liveboxandy/ZX48K-Essentials/board_photo.jpg

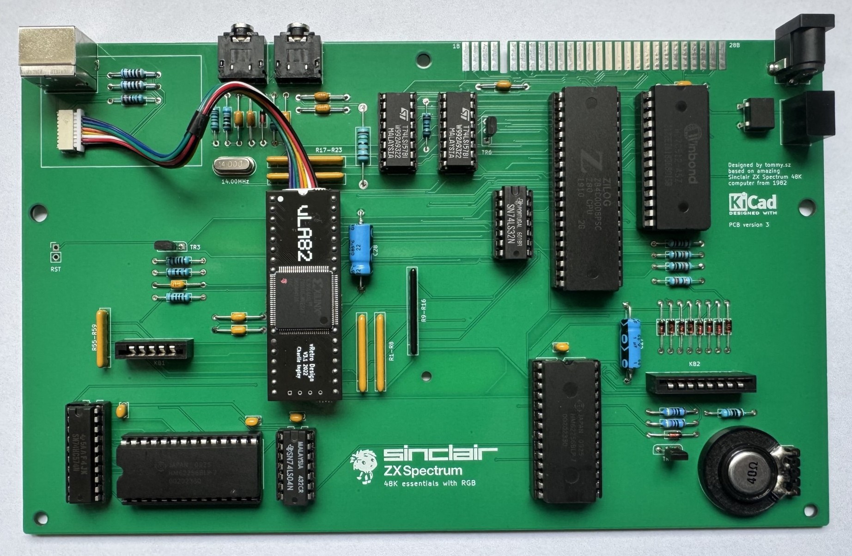
board_photo.jpg
