liveboxandy/ZX48K-Essentials/board_PICTURE.jpg

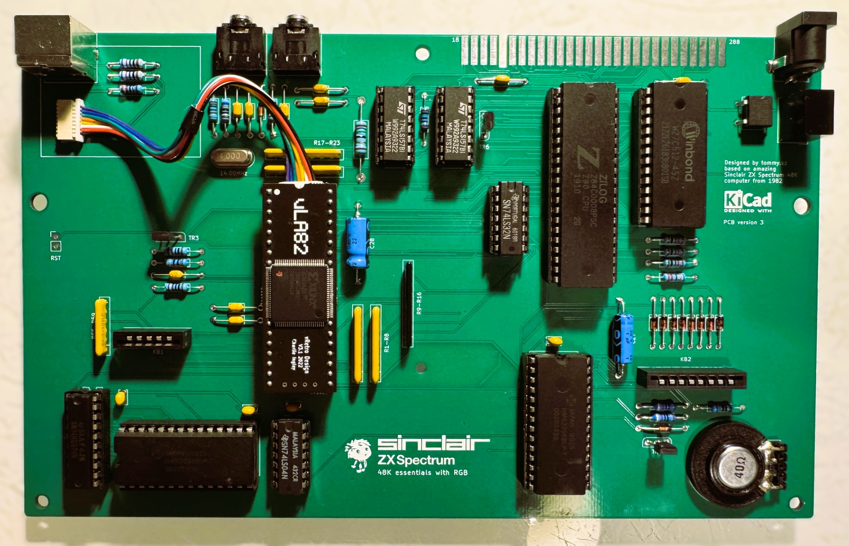
board_PICTURE.jpg
