liveboxandy/ZX48K-Essentials/ZX48K-Essentials_pcb.png

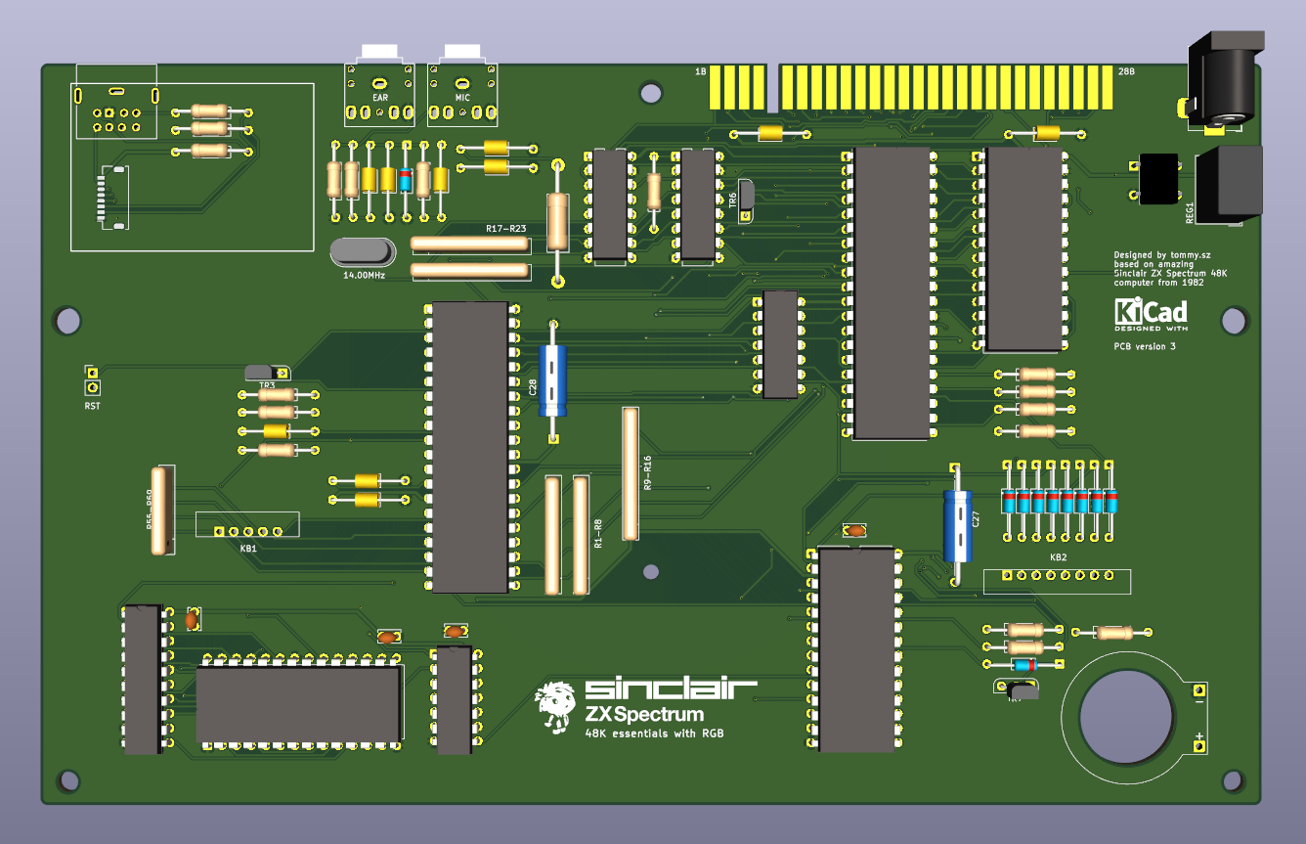
ZX48K-Essentials_pcb.png
