liveboxandy/ZX48K-Essentials/ZX 48K-Populated.png

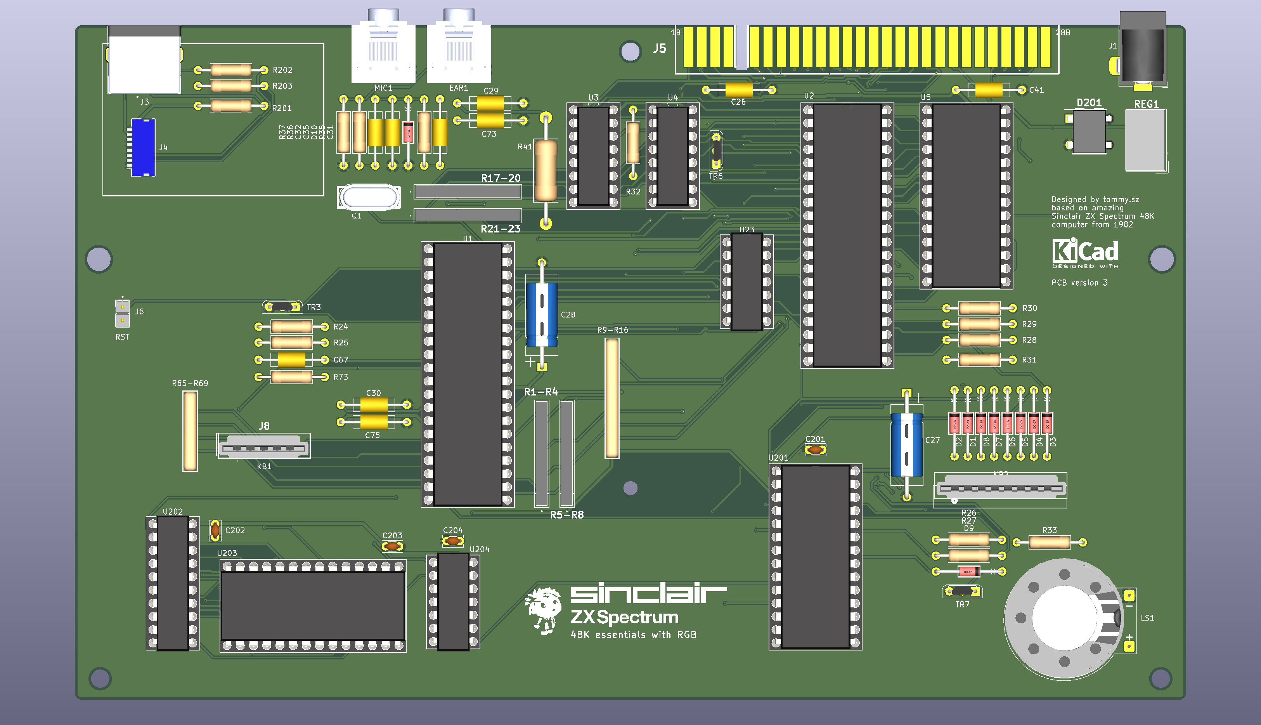
ZX 48K-Populated.png
