liveboxandy/ZX48K-Essentials/ZX 48K-UnPopulated.png

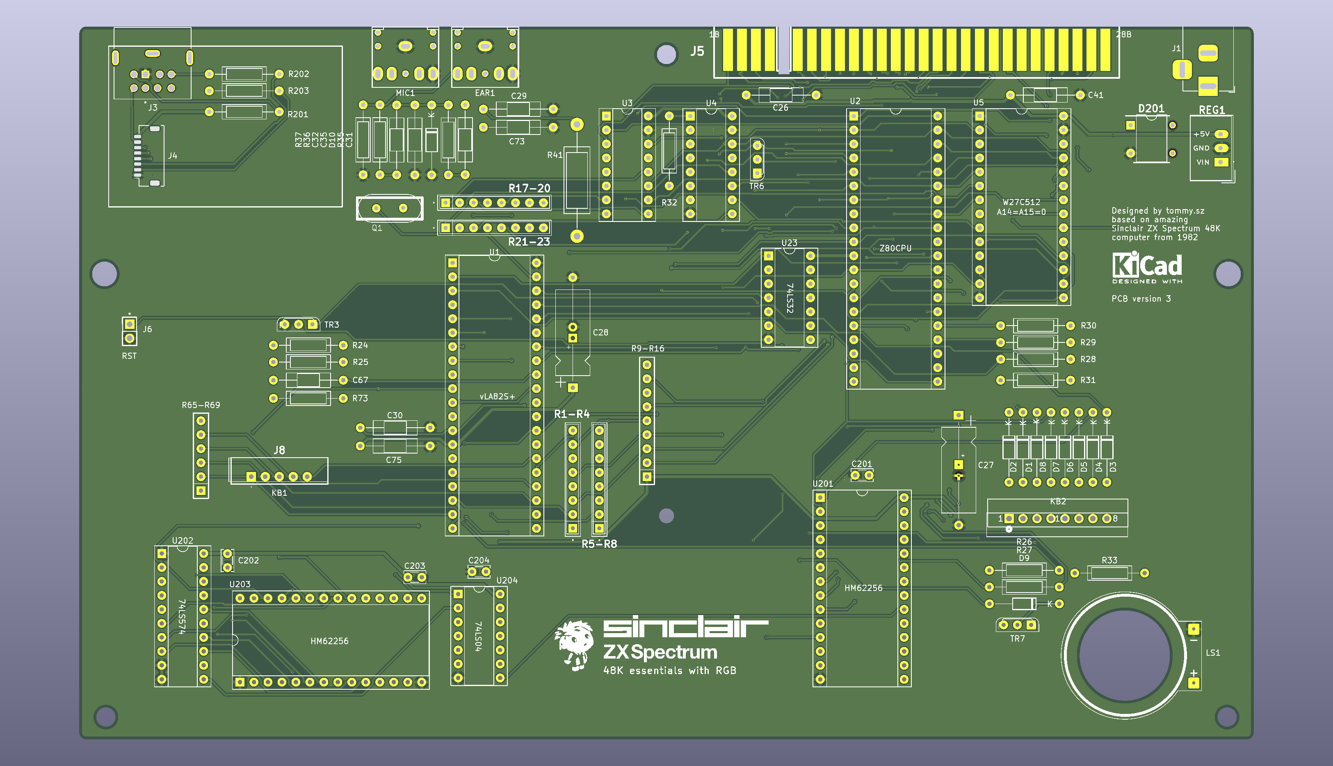
ZX 48K-UnPopulated.png
