liveboxandy/ZX48K-Essentials/ZX48essentials_BOM.pdf

## ZX48essentials - Bill of Materials

Reference | Quantity | Value | Type/Description
Resistors
R24,R37,R73 | 3 | 1K | 0.25W, R=12.7mm
R25 | 1 | 180R | 0.25W, R=12.7mm
R26,R27 | 2 | 470R | 0.25W, R=12.7mm
R28,R29,R30,R35 | 4 | 10K | 0.25W, R=12.7mm
R31 | 1 | 220K | 0.25W, R=12.7mm
R32 | 1 | 100R | 0.25W, R=12.7mm
R33,R36 | 2 | 680R | 0.25W, R=12.7mm
R41 | 1 | 15R | 0.5W or more, R=20.3mm
R201 | 1 | 220R | 0.25W, R=12.7mm
R202,R203 | 2 | 620R | 0.25W, R=12.7mm
Resistor networks
R1-R8 | 2 | 4 x 470R | 8-pin, parallel topology
R9-R16 | 1 | 8 x 8K2 | 9-pin, star topology
R17-R23 | 2 | 4 x 330R | 8-pin, parallel topology
R65-R69 | 1 | 5 x 10K | 6-pin, star topology
Capacitors
C26,C29,C30,C41 | 4 | 47nF | ceramic, axial or disc, R=12.7mm
C27 | 1 | 1uF | electrolytic, axial R=20mm or radial R=2.0mm
C28 | 1 | 22uF | electrolytic, axial R=20mm or radial R=2.0mm
C31,C32,C75 | 3 | 100nF | ceramic, axial or disc, R=12.7mm
C35 | 1 | 10nF | ceramic, axial or disc, R=12.7mm
C67 | 1 | 100pF | ceramic, axial or disc, R=12.7mm
C73 | 1 | 16pF | ceramic, axial or disc, R=12.7mm
C201,C202,C203,C204 | 4 | 100nF | ceramic, R=2.5mm, unmarked on PCB
Diodes
D1-D8,D9-10 | 10 | 1N4148
D201 | 1 | DF02M
Transistors
TR3,TR6 | 2 | ZTX313
TR7 | 1 | ZTX450
Integrated circuits
IC1 | 1 | vLA82S+ | vRetroDesign
IC2 | 1 | Z80 CPU
IC3,IC4 | 2 | 74LS157
IC5 | 1 | W27C512 | EEPROM
IC23 | 1 | 74LS32
U201,U202 | 2 | HM62256
U203 | 1 | 74LS574
U204 | 1 | 74LS04
U205 | 1 | 2450 | Traco TSR-1 or similar
Connectors
J1 | 1 | DC 5.5/2.1
J2 | 1 | 5-pin FFC/FPC | keyboard KB1
J3 | 1 | 8-pin FFC/FPC | keyboard KB2
J4,J5 | 2 | PJ-307 | MIC,EAR
J201 | 1 | Mini-DIN-8 | socket
J202 | 1 | 8-pin JST-SH1.0 | socket horizontal
Other components
Speaker | 1 | 40R | ZX Spectrum speaker
Quartz | 1 | 14.00MHz | HC-49-S
