liveboxandy/ZX48K-Essentials/ZX 48K.csv

Source: | E:\Kicad\ZX 48K\ZX 48K.kicad_sch
Date: | 2026-08-28T11:00:37
Tool: | Eeschema 10.0.4
Generator: | C:\Program Files\KiCad\7.0\bin\scripting\plugins/bom_csv_grouped_by_value_with_fp.py
Component Count: | 76
Ref | Qnty | Value | Cmp name | Footprint | Description | Vendor | DNP
C26, C29, C30, C41 | 4 | 47nF | C | MOD:C_Axial_L7.8mm_D2.4mm_P12.7mm_Horizontal | Unpolarized capacitor
C27 | 1 | 1uF | Capacitor_Electrolytic | MOD:CP_Axial_L15.6mm_D6.0mm_P20.00mm_Horizontal
C28 | 1 | 22uF | Capacitor_Electrolytic | MOD:CP_Axial_L15.6mm_D6.0mm_P20.00mm_Horizontal
C31, C32, C75 | 3 | 100nF | C | MOD:C_Axial_L7.8mm_D2.4mm_P12.7mm_Horizontal | Unpolarized capacitor
C35 | 1 | 10nF | C | MOD:C_Axial_L7.8mm_D2.4mm_P12.7mm_Horizontal | Unpolarized capacitor
C67 | 1 | 100pF | C | MOD:C_Axial_L7.8mm_D2.4mm_P12.7mm_Horizontal | Unpolarized capacitor
C73 | 1 | 16pF | C | MOD:C_Axial_L7.8mm_D2.4mm_P12.7mm_Horizontal | Unpolarized capacitor
C201, C202, C203, C204 | 4 | 100nF | C | MOD:C_Disc_D3.0mm_W1.6mm_P2.50mm | Unpolarized capacitor
D1, D2, D3, D4, D5, D6, D7, D8, D9, D10 | 10 | 1N4148 | 1N4148 | MOD:D_DO-35_SOD27_P12.70mm_Horizontal
D201 | 1 | DF02M | DF02M | MOD:DF02M | Diodes Inc DF02M, Bridge Rectifier, 1A 200V, 4-Pin DFM
EAR1 | 1 | EAR | SJ1-3525N | MOD:PJ-307
J1 | 1 | Power 9V | Barrel_Jack_3_Pin | Connector_BarrelJack:BarrelJack_Horizontal
J3 | 1 | Mini-DIN-8 | Mini-DIN-8 | MOD:KYCON_KMDGX-8S-AS | 8-pin Mini-DIN connector
J4 | 1 | vLA82S+ JST-SH1.0 Connector | JST-SH-08 | MOD:JST_SHL_SM08B-SHLS-TF_1x08-1MP_P1.00mm_Horizontal
J5 | 1 | ZX Spectrum Edge Connector | ZX_48K_EDGE_B_TOP | MOD:ZX_BUS_B_TOP | ZX Spectrum 48K Edge Connector B Top
J6 | 1 | Reset | Conn_01x02 | MOD:SAMTEC_TSW-102-07-G-S | Generic connector, single row, 01x02, script generated (kicad-library-utils/schlib/autogen/connector/)
J8 | 1 | Keyboard KB1 | 5-520315-5 | MOD:Keyboard5x1 | 5 Position FFC, FPC Connector Contacts, Vertical - 1 Sided 0.100" (2.54mm) Through Hole
J11 | 1 | Keyboard KB2 | 5-520315-8 | MOD:Keyboard8x1
LS1 | 1 | 40R | Speaker | MOD:Speaker | Speaker
MIC1 | 1 | MIC | SJ1-3525N | MOD:PJ-307
Q1 | 1 | 14Mhz | Crystal | MOD:X1 | Two pin crystal
R1-R4 | 1 | 4 x 470R | R_Pack04 | MOD:4308R102203LF | 4 resistor network, parallel topology
R5-R8 | 1 | 4 x 470R | R_Pack04 | MOD:4308R102203LF | 4 resistor network, parallel topology
R9-R16 | 1 | 8 x 8K2 | R_Network08 | Resistor_THT:R_Array_SIP9 | 8 resistor network, star topology, bussed resistors, small symbol
R17-20 | 1 | 4 x 330R | R_Pack04 | MOD:4308R102203LF | 4 resistor network, parallel topology
R21-23 | 1 | 4 x 330R | R_Pack04 | MOD:4308R102203LF | 4 resistor network, parallel topology
R24, R37, R73 | 3 | 1K | R | MOD:R_Axial_L7.8mm_D2.4mm_P12.7mm_Horizontal | Resistor
R25 | 1 | 180R | R | MOD:R_Axial_L7.8mm_D2.4mm_P12.7mm_Horizontal | Resistor
R26, R27 | 2 | 470R | R | MOD:R_Axial_L7.8mm_D2.4mm_P12.7mm_Horizontal | Resistor
R28, R29, R30, R35 | 4 | 10K | R | MOD:R_Axial_L7.8mm_D2.4mm_P12.7mm_Horizontal | Resistor
R31 | 1 | 220K | R | MOD:R_Axial_L7.8mm_D2.4mm_P12.7mm_Horizontal | Resistor
R32 | 1 | 100R | R | MOD:R_Axial_L7.8mm_D2.4mm_P12.7mm_Horizontal | Resistor
R33, R36 | 2 | 680R | R | MOD:R_Axial_L7.8mm_D2.4mm_P12.7mm_Horizontal | Resistor
R41 | 1 | 15R | R | MOD:R_Axial_DIN0414_L11.9mm_D4.5mm_P20.32mm_Horizontal | Resistor
R65-R69 | 1 | 5 x 10K | R_Network05 | MOD:R_Array_SIP6 | 5 resistor network, star topology, bussed resistors, small symbol
R201 | 1 | 220R | R | MOD:R_Axial_L7.8mm_D2.4mm_P12.7mm_Horizontal | Resistor
R202, R203 | 2 | 620R | R | MOD:R_Axial_L7.8mm_D2.4mm_P12.7mm_Horizontal | Resistor
REG1 | 1 | TSR_1-2450E | TSR_1-2450E | MOD:TSR12450E
TR3, TR6 | 2 | ZTX313 | ZTX650 | MOD:TO-92Flat
TR7 | 1 | ZTX450 | ZTX650 | MOD:TO-92Flat
U1 | 1 | ULA | ULA | MOD:DIP-40_W15.24mm_Socket
U2 | 1 | Z80 | Z80CPU | MOD:DIP-40_W15.24mm_Socket | 8-bit General Purpose Microprocessor, DIP-40
U3, U4 | 2 | 74LS157 | 74LS157 | MOD:DIP-16_W7.62mm_Socket
U5 | 1 | W27C512 | W27C512 | MOD:DIP-28_W15.24mm_Socket
U23 | 1 | 74LS32 | 74LS32 | MOD:DIP-14_W7.62mm_Socket | Quad 2-input OR
U201, U203 | 2 | 62256 | 62256 | MOD:DIP-28_W15.24mm_Socket
U202 | 1 | 74LS574 | 74LS574 | MOD:DIP-20_W7.62mm_Socket | 8-bit Register, 3-state outputs
U204 | 1 | 74LS04 | 74LS04 | MOD:DIP-14_W7.62mm_Socket | Hex Inverter
