liveboxandy/ZX48K-Essentials/STPS/4308R-102-203LF.stp

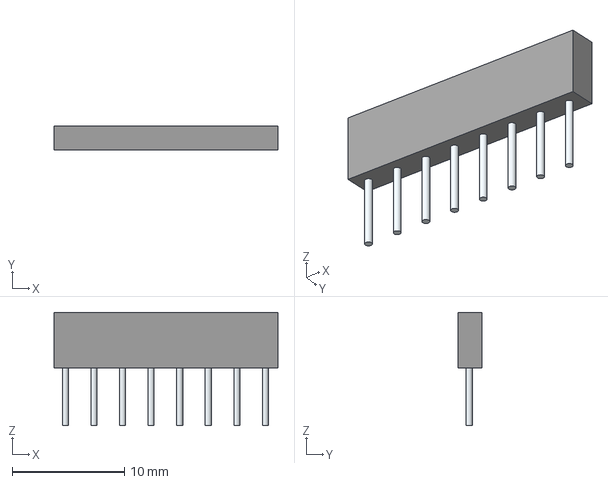
[picture p7: CAD file, 2026-08-28]
STPS/4308R-102-203LF.stp
19.9 x 2.16 x 10.1 mm
Leads x 8
