liveboxandy/ZX48K-Essentials/STPS/TSW-102-07-G-S.step

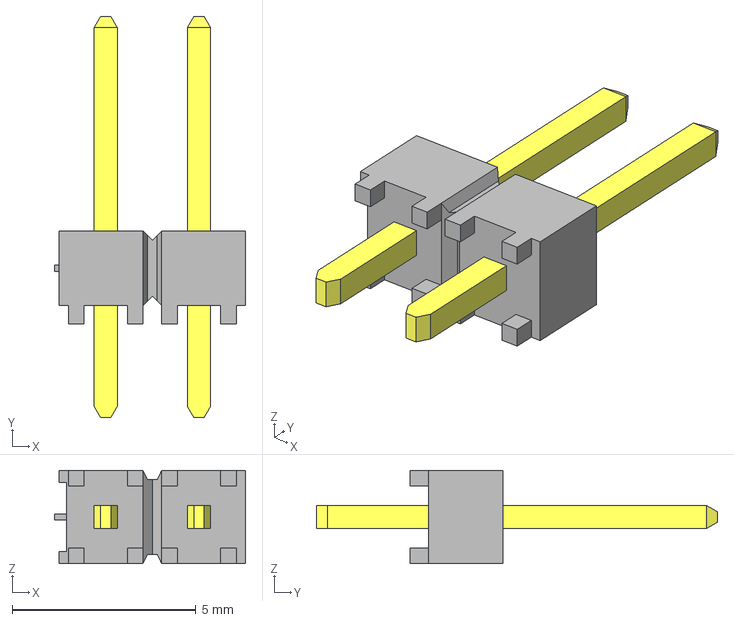
[picture p8: CAD file, 2026-08-28]
STPS/TSW-102-07-G-S.step
5.21 x 10.9 x 2.54 mm
TSW-102-07-G-S_body
T-1S6-07-TSW-1-07-2-S
