liveboxandy/ZX48K-Essentials/STPS/DF02M.stp

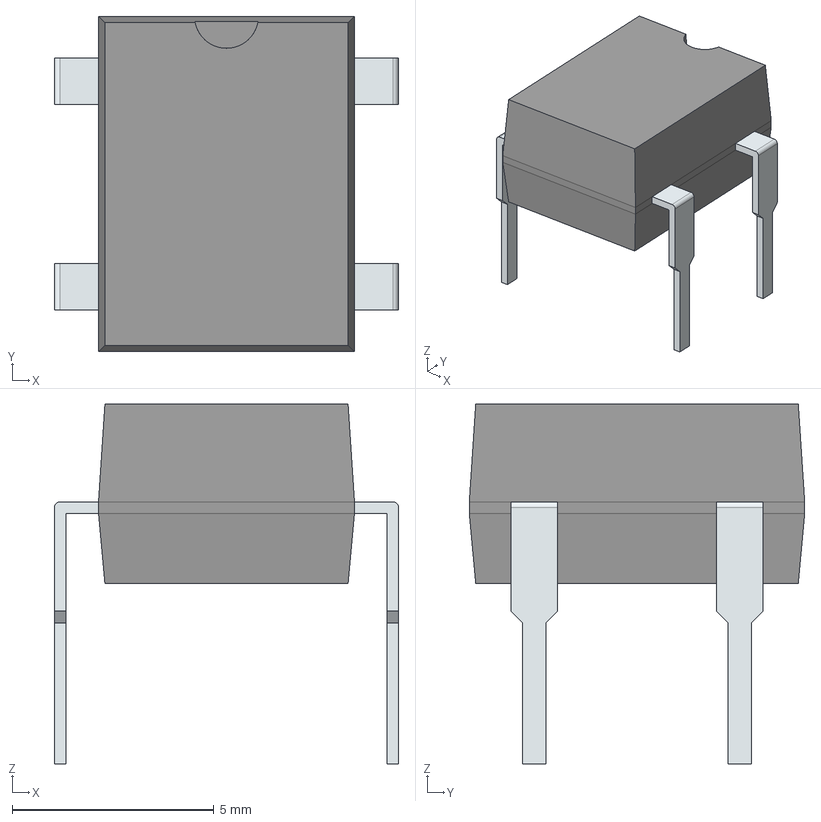
[picture p9: CAD file, 2026-08-28]
STPS/DF02M.stp
8.54 x 8.32 x 8.93 mm
PinsArrayLR
