liveboxandy/ZX48K-Essentials/ZX 48K.pdf

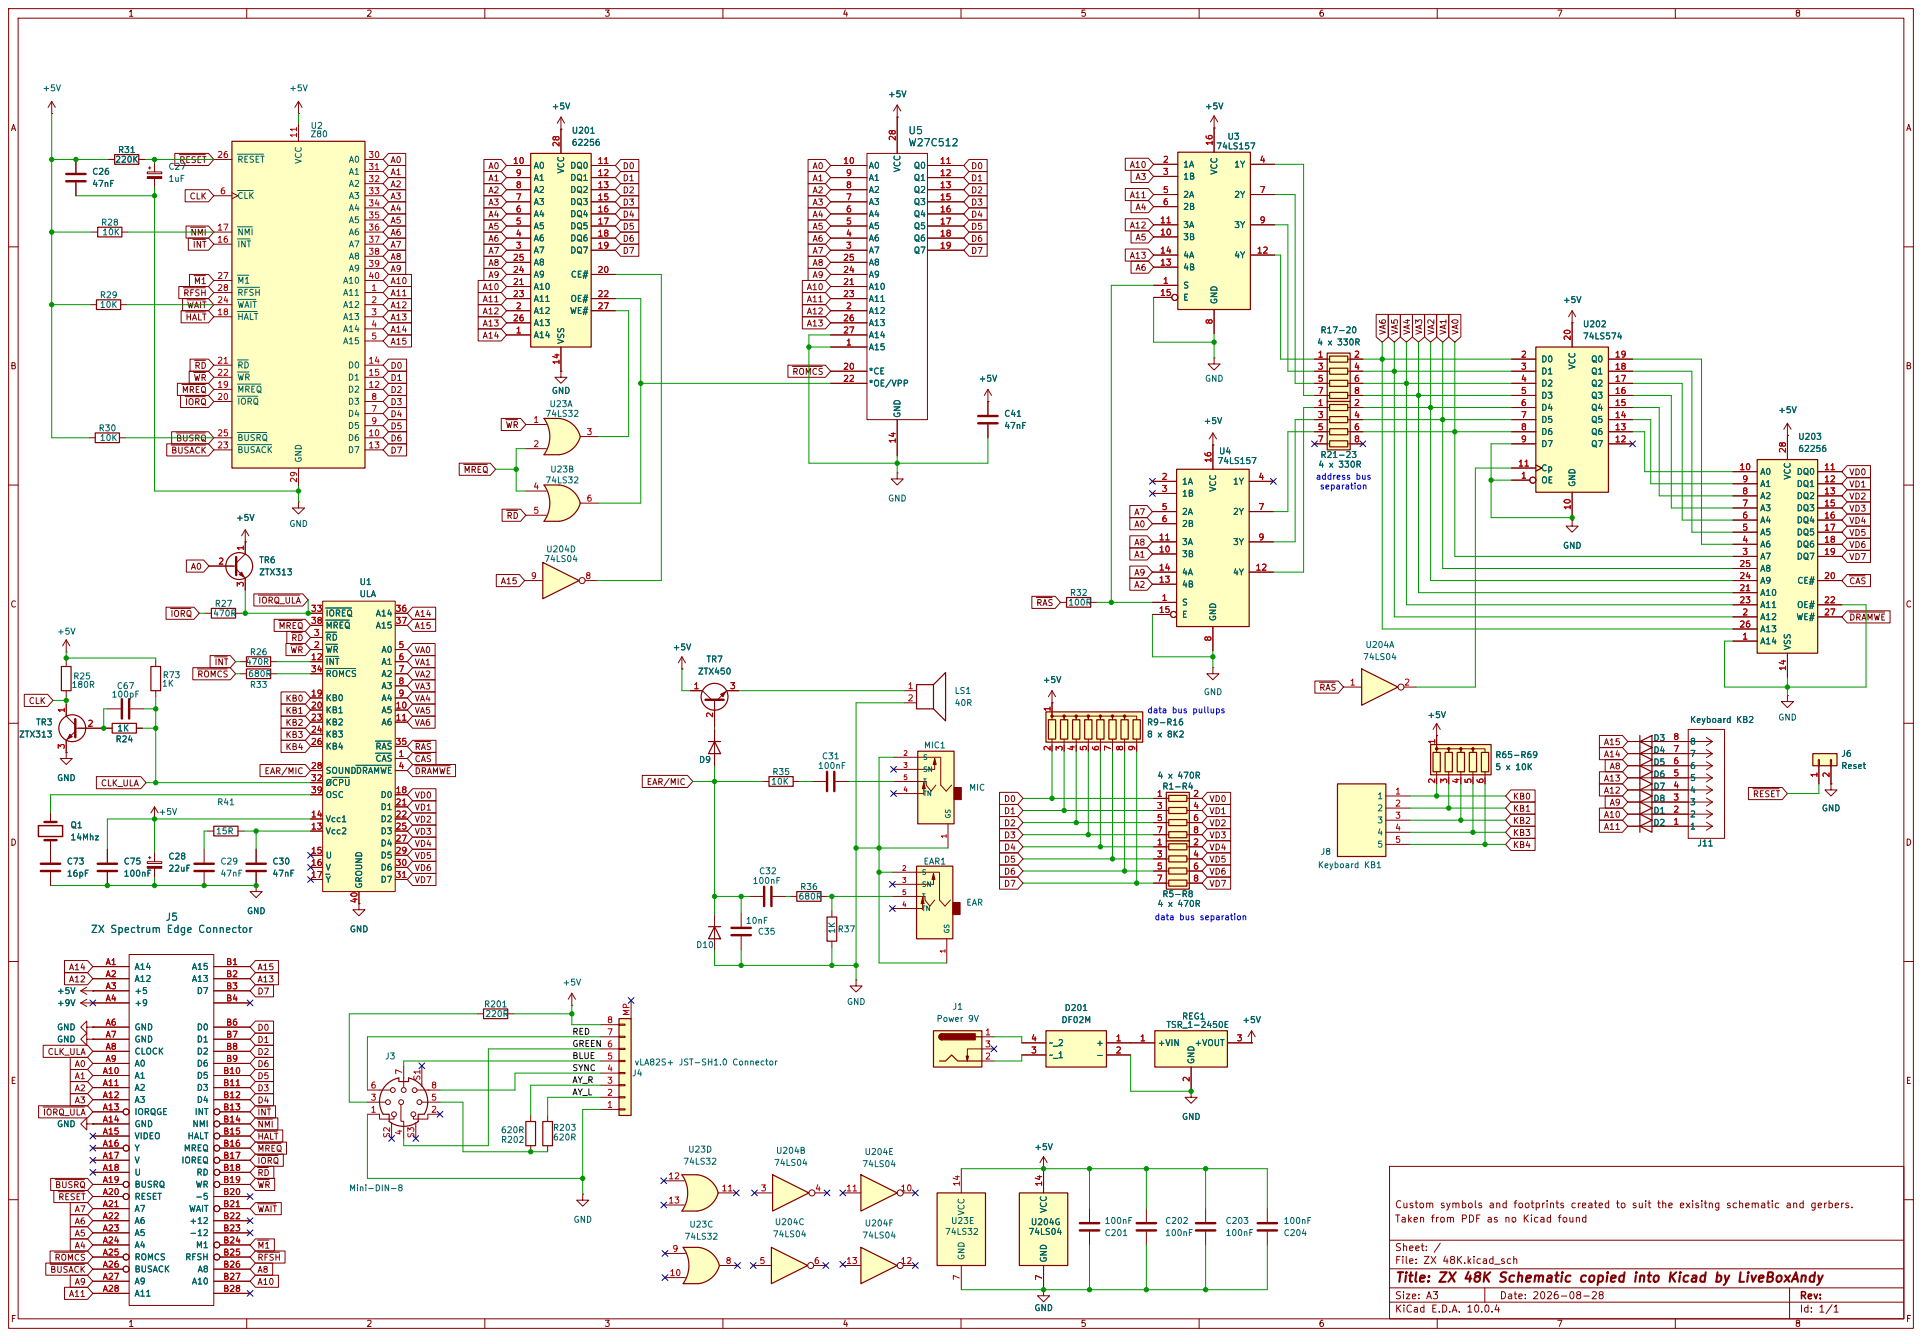
[picture p11: page 1]

EAR/MIC WAIT M1 RFSH
HALT RD

3 3 | | 4 4
5 5 | | 6 6

T 5 EAR1 SN 3

ZX Spectrum Edge Connector A14 A1

Custom symbols and footprints created to suit the exisitng schematic and gerbers.
Taken from PDF as no Kicad found

Sheet: /
File: ZX 48K.kicad_sch
Title: ZX 48K Schematic copied into Kicad by LiveBoxAndy

Size: A3 | Rev: | F Date: 2026-08-28
KiCad E.D.A. 10.0.4 | Id: 1/1
