liveboxandy/ZX48K-Essentials/ZX48K-Essentials_schematic.pdf

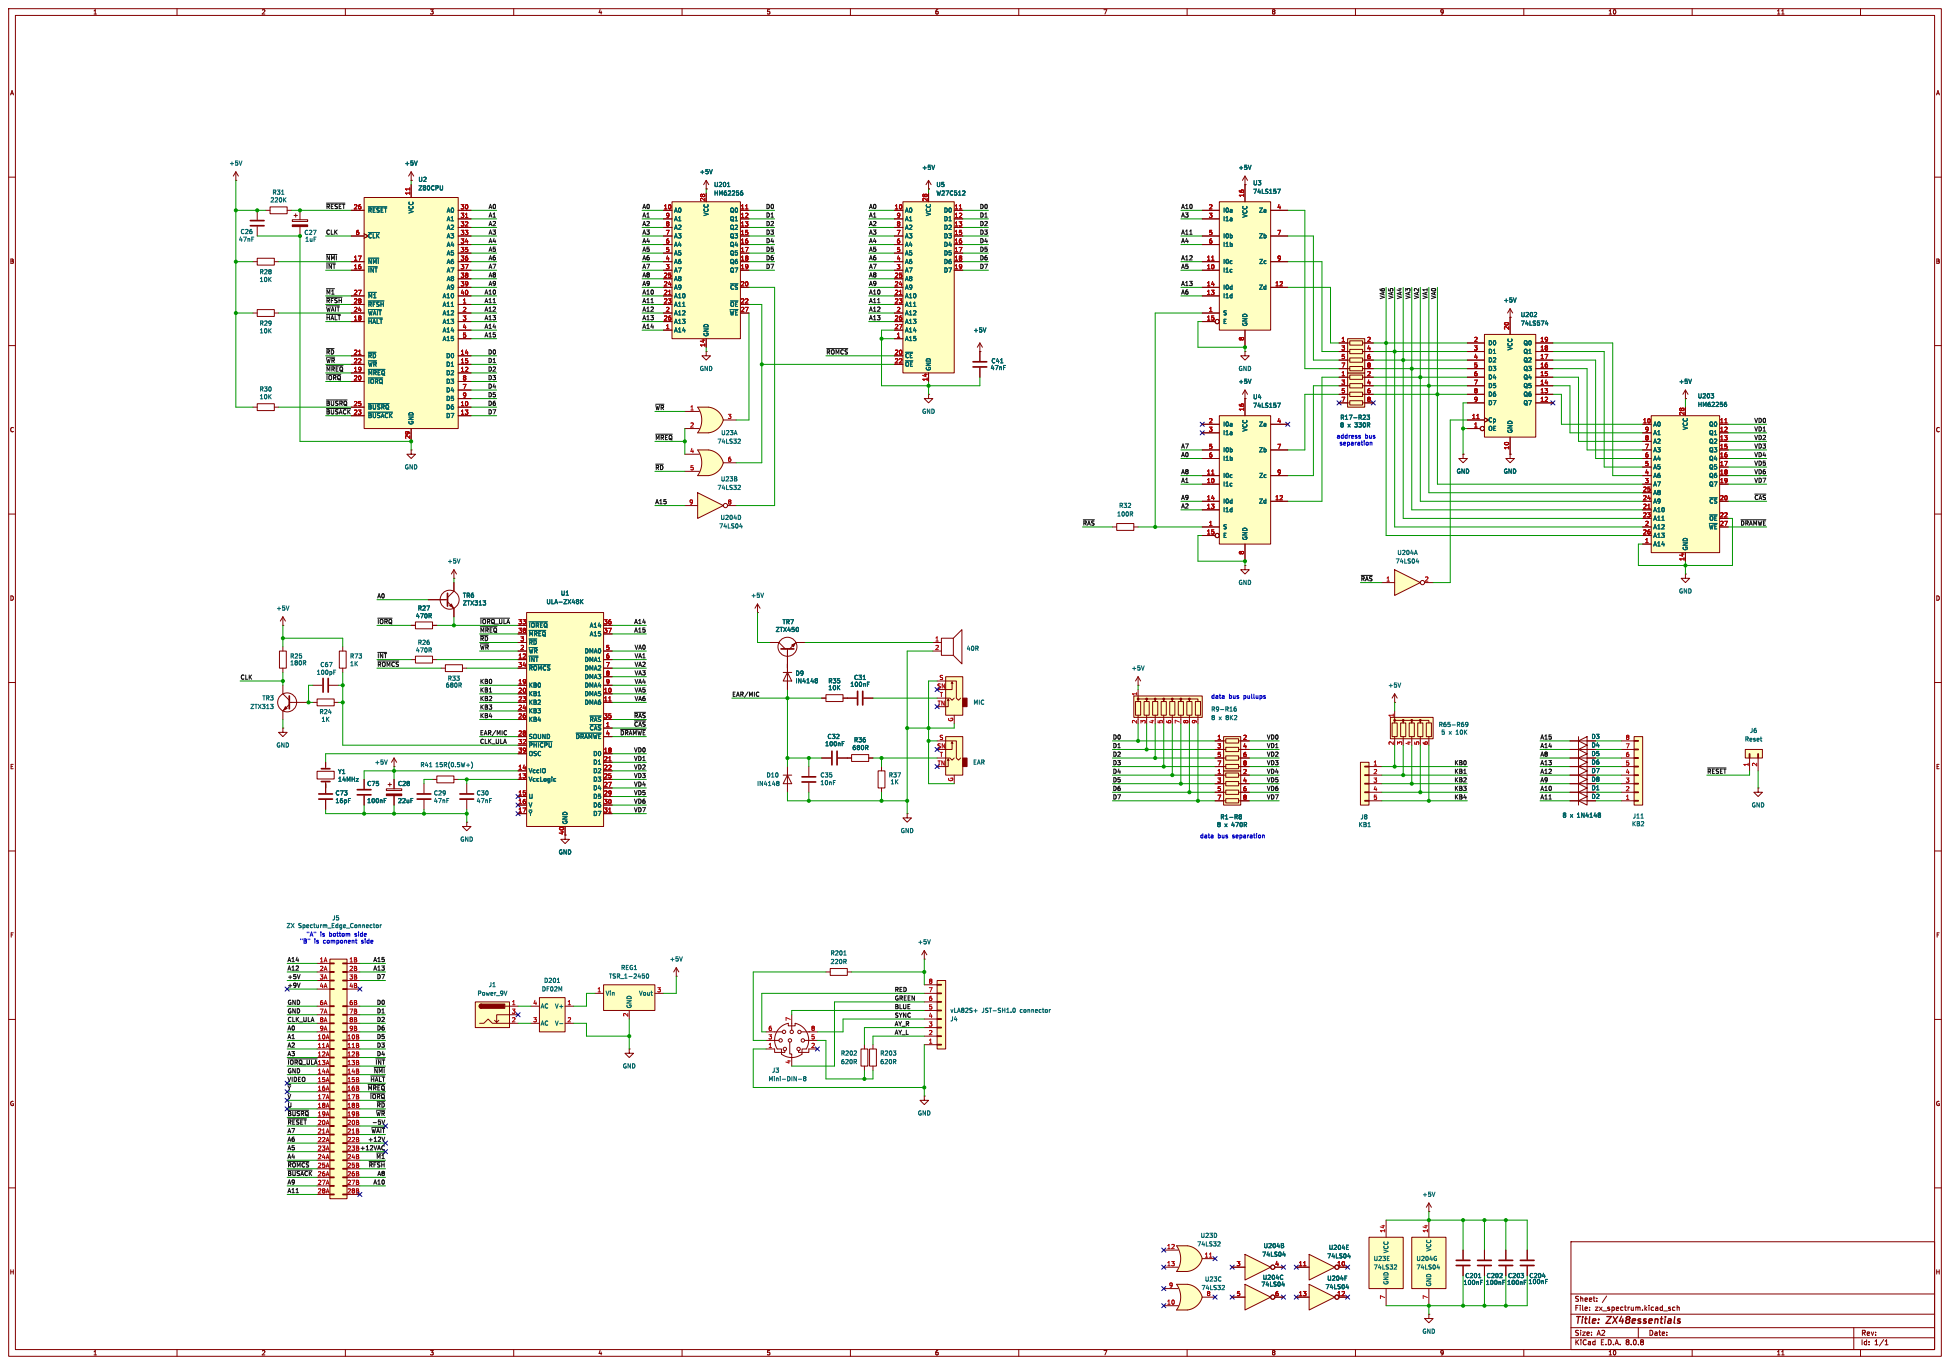
[picture p12: page 1]

IN4148 ~{CAS}1 DMA5 10 DMA6 11 ~{INT} 12 VccLogic 13 VccIO 14 U

~{CAS}1 DMA5 10 DMA6 11 ~{INT} 12 VccLogic 13 VccIO 14 U
