liveboxandy/ZX48K-Essentials/ZX 48K.kicad_pcb

## KiCad design ZX 48K.kicad_pcb (2026-08-28)

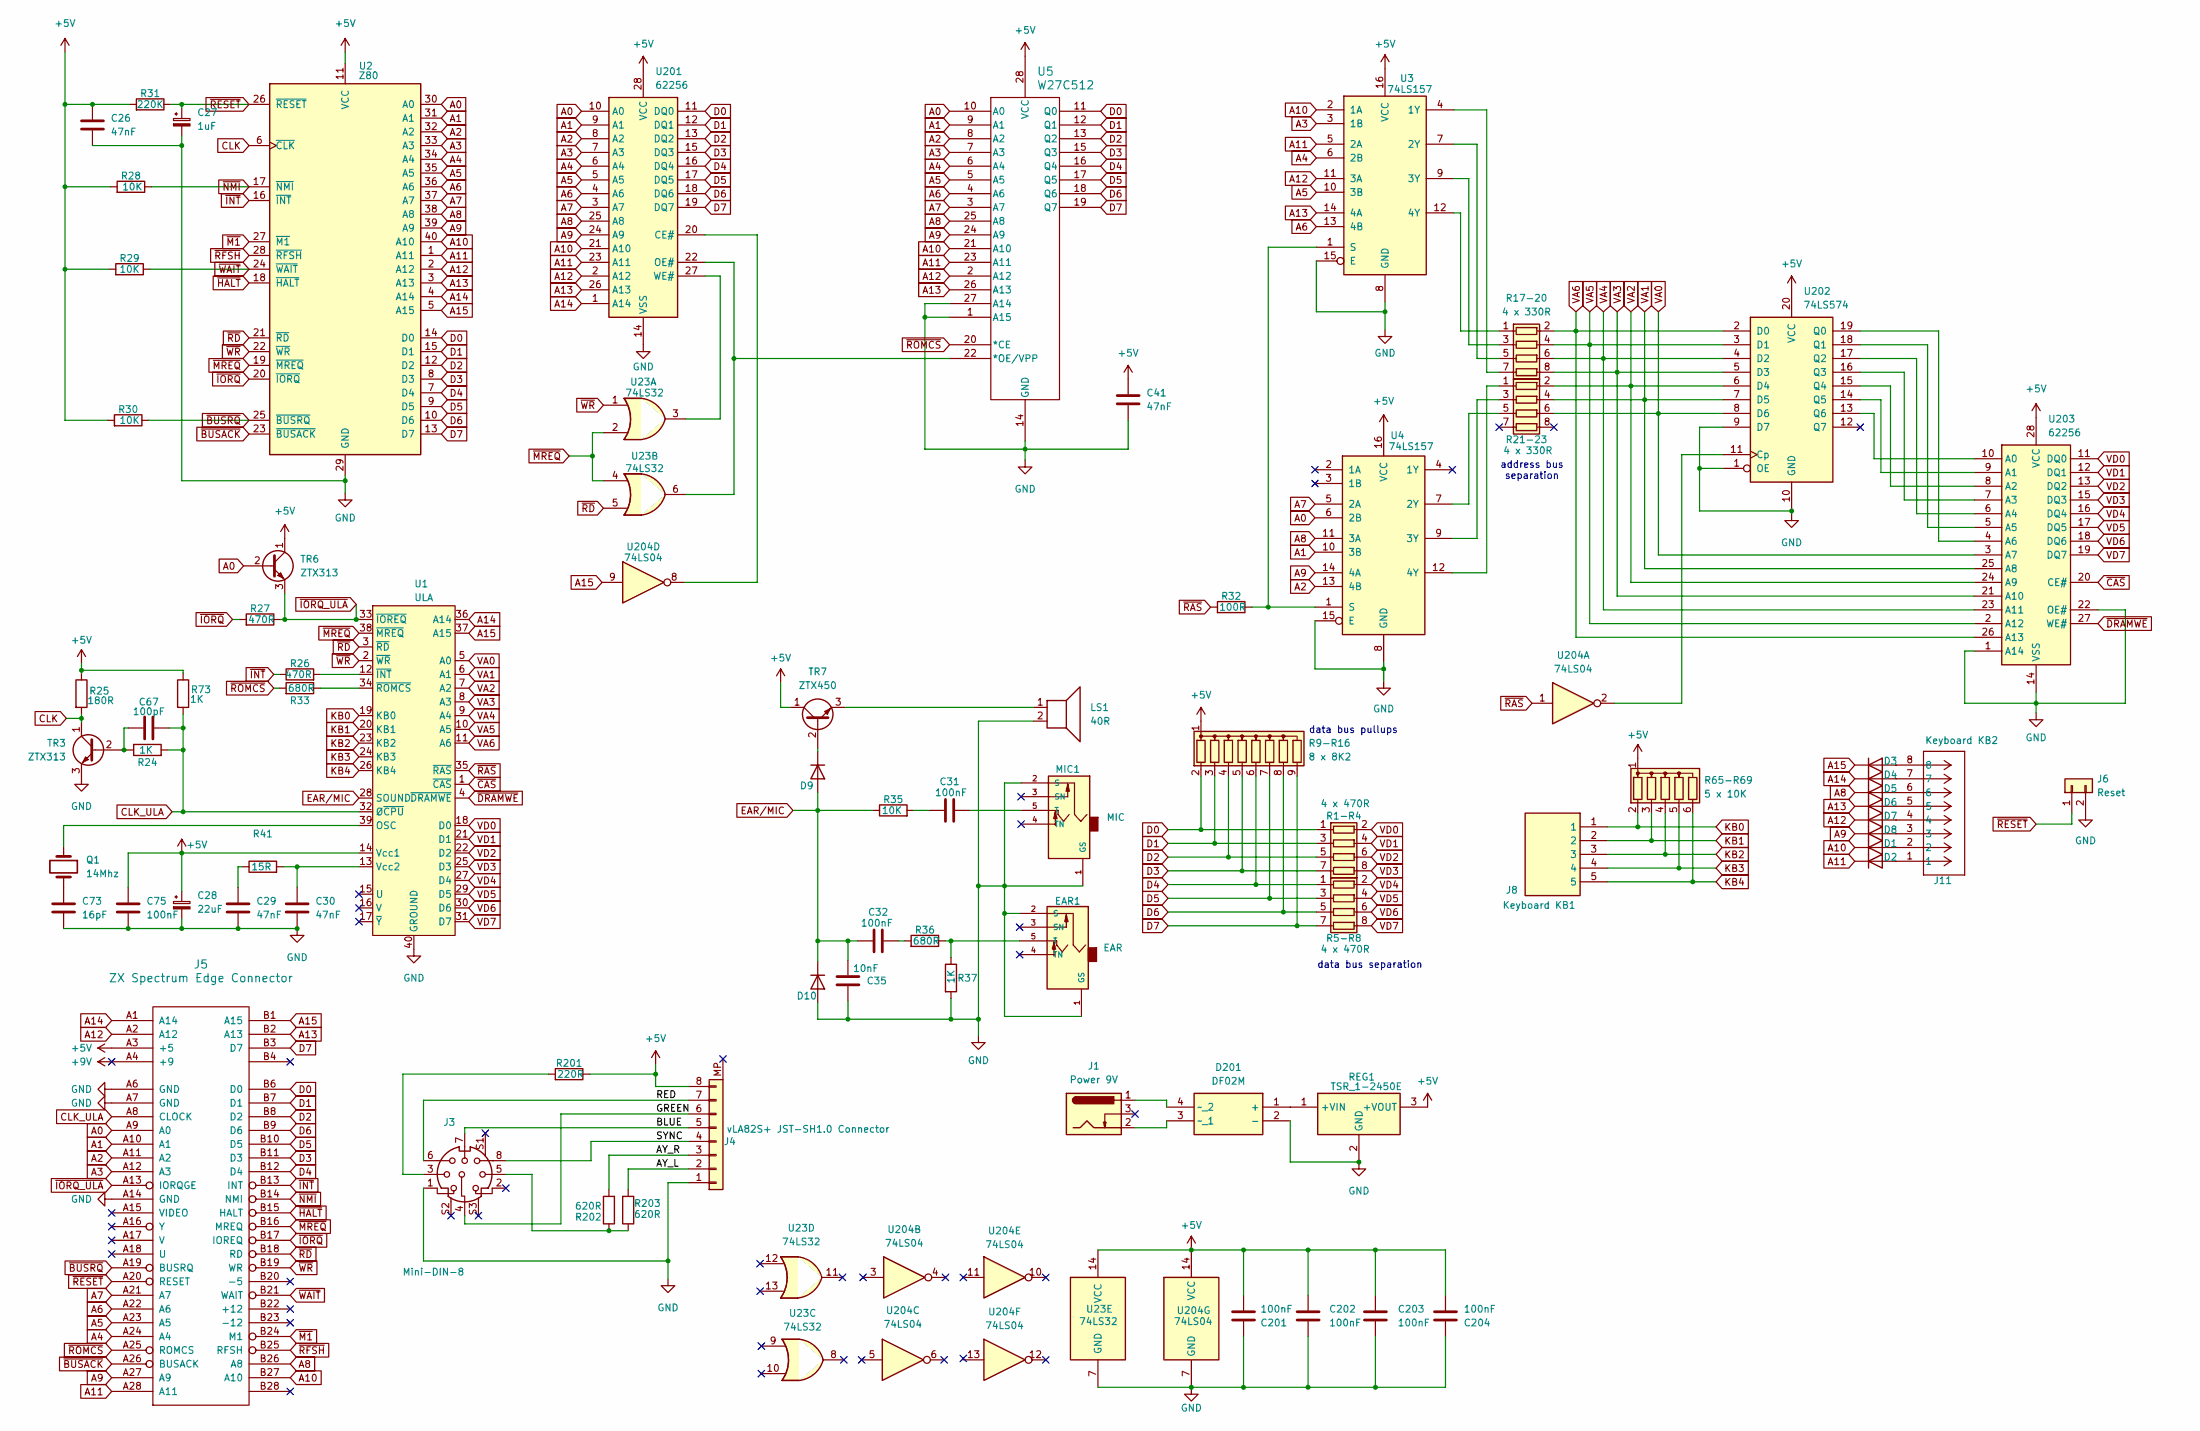
[picture p13: schematic ZX 48K.kicad_sch, ZX 48K Schematic copied into Kicad by LiveBoxAndy]

Parts:
C26, C29, C30, C41: 47nF; C_Axial_L7.8mm_D2.4mm_P12.7mm_Horizontal
C27: 1uF; CP_Axial_L15.6mm_D6.0mm_P20.00mm_Horizontal
C28: 22uF; CP_Axial_L15.6mm_D6.0mm_P20.00mm_Horizontal
C31, C32, C75: 100nF; C_Axial_L7.8mm_D2.4mm_P12.7mm_Horizontal
C35: 10nF; C_Axial_L7.8mm_D2.4mm_P12.7mm_Horizontal
C67: 100pF; C_Axial_L7.8mm_D2.4mm_P12.7mm_Horizontal
C73: 16pF; C_Axial_L7.8mm_D2.4mm_P12.7mm_Horizontal
C201, C202, C203, C204: 100nF; C_Disc_D3.0mm_W1.6mm_P2.50mm
D1, D2, D3, D4, D5, D6, D7, D8, D9, D10: 1N4148; D_DO-35_SOD27_P12.70mm_Horizontal
D201: DF02M
EAR1: EAR; PJ-307
J1: Power 9V; BarrelJack_Horizontal
J3: Mini-DIN-8; KYCON_KMDGX-8S-AS
J4: vLA82S+ JST-SH1.0 Connector; JST_SHL_SM08B-SHLS-TF_1x08-1MP_P1.00mm_Horizontal
J5: ZX Spectrum Edge Connector; ZX_BUS_B_TOP
J6: Reset; SAMTEC_TSW-102-07-G-S
J8: Keyboard KB1; Keyboard5x1
J11: Keyboard KB2; Keyboard8x1
LS1: 40R; Speaker
MIC1: MIC; PJ-307
Q1: 14Mhz; X1
R1-R4, R5-R8: 4 x 470R; 4308R102203LF
R9-R16: 8 x 8K2; R_Array_SIP9
R17-20, R21-23: 4 x 330R; 4308R102203LF
R24, R37, R73: 1K; R_Axial_L7.8mm_D2.4mm_P12.7mm_Horizontal
R25: 180R; R_Axial_L7.8mm_D2.4mm_P12.7mm_Horizontal
R26, R27: 470R; R_Axial_L7.8mm_D2.4mm_P12.7mm_Horizontal
R28, R29, R30, R35: 10K; R_Axial_L7.8mm_D2.4mm_P12.7mm_Horizontal
R31: 220K; R_Axial_L7.8mm_D2.4mm_P12.7mm_Horizontal
R32: 100R; R_Axial_L7.8mm_D2.4mm_P12.7mm_Horizontal
R33, R36: 680R; R_Axial_L7.8mm_D2.4mm_P12.7mm_Horizontal
R41: 15R; R_Axial_DIN0414_L11.9mm_D4.5mm_P20.32mm_Horizontal
R65-R69: 5 x 10K; R_Array_SIP6
R201: 220R; R_Axial_L7.8mm_D2.4mm_P12.7mm_Horizontal
R202, R203: 620R; R_Axial_L7.8mm_D2.4mm_P12.7mm_Horizontal
REG1: TSR_1-2450E; TSR12450E
TR3, TR6: ZTX313; TO-92Flat
TR7: ZTX450; TO-92Flat
U1: ULA; DIP-40_W15.24mm_Socket
U2: Z80; DIP-40_W15.24mm_Socket
U3, U4: 74LS157; DIP-16_W7.62mm_Socket
U5: W27C512; DIP-28_W15.24mm_Socket
U23: 74LS32; DIP-14_W7.62mm_Socket
U201, U203: 62256; DIP-28_W15.24mm_Socket
U202: 74LS574; DIP-20_W7.62mm_Socket
U204: 74LS04; DIP-14_W7.62mm_Socket

Connections:
+5V: C26.1, C28.1, C41.1, C75.1, C201.2, C202.1, C203.1, C204.2, J4.8, J5.A3 (+5), R9-R16.1 (common), R25.1, R28.2, R29.2, R30.2, R31.2, R65-R69.1 (common), R73.1, R201.1, REG1.3 (+VOUT), TR6.1 (C), TR7.1 (C), U1.14 (Vcc1), U2.11 (VCC), U3.16 (VCC), U4.16 (VCC), U5.28 (VCC), U23.14 (VCC), U201.28 (VCC), U202.20 (VCC), U203.28 (VCC), U204.14 (VCC)
+9V: J5.A4 (+9)
/AY_L: J4.2, R203.2
/AY_R: J4.3, R202.2
/BLUE: J3.7, J4.5
/GREEN: J3.4, J4.6
/RED: J3.6, J4.7
/SYNC: J3.8, J4.4
A0: J5.A9 (A0), TR6.2 (B), U2.30 (A0), U4.6 (2B), U5.10 (A0), U201.10 (A0)
A1: J5.A10 (A1), U2.31 (A1), U4.10 (3B), U5.9 (A1), U201.9 (A1)
A2: J5.A11 (A2), U2.32 (A2), U4.13 (4B), U5.8 (A2), U201.8 (A2)
A3: J5.A12 (A3), U2.33 (A3), U3.3 (1B), U5.7 (A3), U201.7 (A3)
A4: J5.A24 (A4), U2.34 (A4), U3.6 (2B), U5.6 (A4), U201.6 (A4)
A5: J5.A23 (A5), U2.35 (A5), U3.10 (3B), U5.5 (A5), U201.5 (A5)
A6: J5.A22 (A6), U2.36 (A6), U3.13 (4B), U5.4 (A6), U201.4 (A6)
A7: J5.A21 (A7), U2.37 (A7), U4.5 (2A), U5.3 (A7), U201.3 (A7)
A8: D5.1 (K), J5.B26 (A8), U2.38 (A8), U4.11 (3A), U5.25 (A8), U201.25 (A8)
A9: D8.1 (K), J5.A27 (A9), U2.39 (A9), U4.14 (4A), U5.24 (A9), U201.24 (A9)
A10: D1.1 (K), J5.B27 (A10), U2.40 (A10), U3.2 (1A), U5.21 (A10), U201.21 (A10)
A11: D2.1 (K), J5.A28 (A11), U2.1 (A11), U3.5 (2A), U5.23 (A11), U201.23 (A11)
A12: D7.1 (K), J5.A2 (A12), U2.2 (A12), U3.11 (3A), U5.2 (A12), U201.2 (A12)
A13: D6.1 (K), J5.B2 (A13), U2.3 (A13), U3.14 (4A), U5.26 (A13), U201.26 (A13)
A14: D4.1 (K), J5.A1 (A14), U1.36 (A14), U2.4 (A14), U201.1 (A14)
A15: D3.1 (K), J5.B1 (A15), U1.37 (A15), U2.5 (A15), U204.9
CLK: R25.2, TR3.1 (C), U2.6 (~CLK)
CLK_ULA: C67.2, J5.A8 (CLOCK), R24.2, R73.2, U1.32 (Ø~CPU)
D0: J5.B6 (D0), R1-R4.1 (R1.1), R9-R16.2 (R1), U2.14 (D0), U5.11 (Q0), U201.11 (DQ0)
D1: J5.B7 (D1), R1-R4.3 (R2.1), R9-R16.3 (R2), U2.15 (D1), U5.12 (Q1), U201.12 (DQ1)
D2: J5.B8 (D2), R1-R4.5 (R3.1), R9-R16.4 (R3), U2.12 (D2), U5.13 (Q2), U201.13 (DQ2)
D3: J5.B11 (D3), R1-R4.7 (R4.1), R9-R16.5 (R4), U2.8 (D3), U5.15 (Q3), U201.15 (DQ3)
D4: J5.B12 (D4), R5-R8.1 (R1.1), R9-R16.6 (R5), U2.7 (D4), U5.16 (Q4), U201.16 (DQ4)
D5: J5.B10 (D5), R5-R8.3 (R2.1), R9-R16.7 (R6), U2.9 (D5), U5.17 (Q5), U201.17 (DQ5)
D6: J5.B9 (D6), R5-R8.5 (R3.1), R9-R16.8 (R7), U2.10 (D6), U5.18 (Q6), U201.18 (DQ6)
D7: J5.B3 (D7), R5-R8.7 (R4.1), R9-R16.9 (R8), U2.13 (D7), U5.19 (Q7), U201.19 (DQ7)
EAR/MIC: C32.1, C35.1, D9.2 (A), D10.1 (K), R35.1, U1.28 (SOUND)
GND: C26.2, C27.2, C28.2, C29.2, C30.2, C35.2, C41.2, C73.2, C75.2, C201.1, C202.2, C203.2, C204.1, D10.2 (A), D201.2 (-), EAR1.1 (GS), EAR1.2 (S), J3.1, J4.1, J5.A6 (GND), J5.A7 (GND), J5.A14 (GND), J6.2, LS1.2, MIC1.1 (GS), MIC1.2 (S), R37.2, REG1.2 (GND), TR3.3 (E), U1.40 (GROUND), U2.29 (GND), U3.8 (GND), U3.15 (E), U4.8 (GND), U4.15 (E), U5.1 (A15), U5.14 (GND), U5.27 (A14), U23.7 (GND), U201.14 (VSS), U202.1 (OE), U202.9 (D7), U202.10 (GND), U203.1 (A14), U203.14 (VSS), U203.22 (OE#), U204.7 (GND)
KB0: J8.1, R65-R69.2 (R1), U1.19 (KB0)
KB1: J8.2, R65-R69.3 (R2), U1.20 (KB1)
KB2: J8.3, R65-R69.4 (R3), U1.23 (KB2)
KB3: J8.4, R65-R69.5 (R4), U1.24 (KB3)
KB4: J8.5, R65-R69.6 (R5), U1.26 (KB4)
unnamed: C29.1, R41.1
unnamed: C31.2, R35.2
unnamed: C32.2, R36.2
unnamed: C73.1, Q1.2
unnamed: D1.2 (A), J11.2
unnamed: D2.2 (A), J11.1
unnamed: D3.2 (A), J11.8
unnamed: D4.2 (A), J11.7
unnamed: D5.2 (A), J11.6
unnamed: D6.2 (A), J11.5
unnamed: D7.2 (A), J11.4
unnamed: D8.2 (A), J11.3
unnamed: D9.1 (K), TR7.2 (B)
unnamed: D201.1 (+), REG1.1 (+VIN)
unnamed: D201.3 (~_1), J1.2
unnamed: D201.4 (~_2), J1.1
unnamed: EAR1.5 (T), R36.1, R37.1
unnamed: J3.3, R201.2
unnamed: J3.5, R202.1, R203.1
unnamed: C31.1, MIC1.5 (T)
unnamed: R17-20.1 (R1.1), U3.12 (4Y)
unnamed: R17-20.3 (R2.1), U3.9 (3Y)
unnamed: R17-20.5 (R3.1), U3.7 (2Y)
unnamed: R17-20.7 (R4.1), U3.4 (1Y)
unnamed: R21-23.1 (R1.1), U4.12 (4Y)
unnamed: R21-23.3 (R2.1), U4.9 (3Y)
unnamed: R21-23.5 (R3.1), U4.7 (2Y)
unnamed: C67.1, R24.1, TR3.2 (B)
unnamed: LS1.1, TR7.3 (E)
unnamed: Q1.1, U1.39 (OSC)
unnamed: C30.1, R41.2, U1.13 (Vcc2)
unnamed: R26.2, U1.12 (~INT)
unnamed: R33.1, U1.34 (~ROMCS)
unnamed: R32.1, U3.1 (S), U4.1 (S)
unnamed: U201.20 (CE#), U204.8
unnamed: U5.22 (*OE/VPP), U23.6, U201.22 (OE#)
unnamed: U23.3, U201.27 (WE#)
unnamed: U202.11 (Cp), U204.2
unnamed: U202.19 (Q0), U203.4 (A6)
unnamed: U202.18 (Q1), U203.5 (A5)
unnamed: U202.17 (Q2), U203.6 (A4)
unnamed: U202.16 (Q3), U203.7 (A3)
unnamed: U202.15 (Q4), U203.8 (A2)
unnamed: U202.14 (Q5), U203.9 (A1)
unnamed: U202.13 (Q6), U203.10 (A0)
VA0: R21-23.6 (R3.2), U1.5 (A0), U202.8 (D6), U203.3 (A7)
VA1: R21-23.4 (R2.2), U1.6 (A1), U202.7 (D5), U203.25 (A8)
VA2: R21-23.2 (R1.2), U1.7 (A2), U202.6 (D4), U203.24 (A9)
VA3: R17-20.8 (R4.2), U1.8 (A3), U202.5 (D3), U203.21 (A10)
VA4: R17-20.6 (R3.2), U1.9 (A4), U202.4 (D2), U203.23 (A11)
VA5: R17-20.4 (R2.2), U1.10 (A5), U202.3 (D1), U203.2 (A12)
VA6: R17-20.2 (R1.2), U1.11 (A6), U202.2 (D0), U203.26 (A13)
VD0: R1-R4.2 (R1.2), U1.18 (D0), U203.11 (DQ0)
VD1: R1-R4.4 (R2.2), U1.21 (D1), U203.12 (DQ1)
VD2: R1-R4.6 (R3.2), U1.22 (D2), U203.13 (DQ2)
VD3: R1-R4.8 (R4.2), U1.25 (D3), U203.15 (DQ3)
VD4: R5-R8.2 (R1.2), U1.27 (D4), U203.16 (DQ4)
VD5: R5-R8.4 (R2.2), U1.29 (D5), U203.17 (DQ5)
VD6: R5-R8.6 (R3.2), U1.30 (D6), U203.18 (DQ6)
VD7: R5-R8.8 (R4.2), U1.31 (D7), U203.19 (DQ7)
~BUSACK: J5.A26 (BUSACK), U2.23 (~BUSACK)
~BUSRQ: J5.A19 (BUSRQ), R30.1, U2.25 (~BUSRQ)
~CAS: U1.1 (~CAS), U203.20 (CE#)
~DRAMWE: U1.4 (~DRAMWE), U203.27 (WE#)
~HALT: J5.B15 (HALT), U2.18 (~HALT)
~INT: J5.B13 (INT), R26.1, U2.16 (~INT)
~IORQ_ULA: J5.A13 (IORQGE), R27.1, TR6.3 (E), U1.33 (~IOREQ)
~IORQ: J5.B17 (IOREQ), R27.2, U2.20 (~IORQ)
~M1: J5.B24 (M1), U2.27 (~M1)
~MREQ: J5.B16 (MREQ), U1.38 (~MREQ), U2.19 (~MREQ), U23.2, U23.4
~NMI: J5.B14 (NMI), R28.1, U2.17 (~NMI)
~RAS: R32.2, U1.35 (~RAS), U204.1
~RD: J5.B18 (RD), U1.3 (~RD), U2.21 (~RD), U23.5
~RESET: C27.1, J5.A20 (RESET), J6.1, R31.1, U2.26 (~RESET)
~RFSH: J5.B25 (RFSH), U2.28 (~RFSH)
~ROMCS: J5.A25 (ROMCS), R33.2, U5.20 (*CE)
~WAIT: J5.B21 (WAIT), R29.1, U2.24 (~WAIT)
~WR: J5.B19 (WR), U1.2 (~WR), U2.22 (~WR), U23.1

Notes on the sheet:
address bus separation
data bus separation
data bus pullups

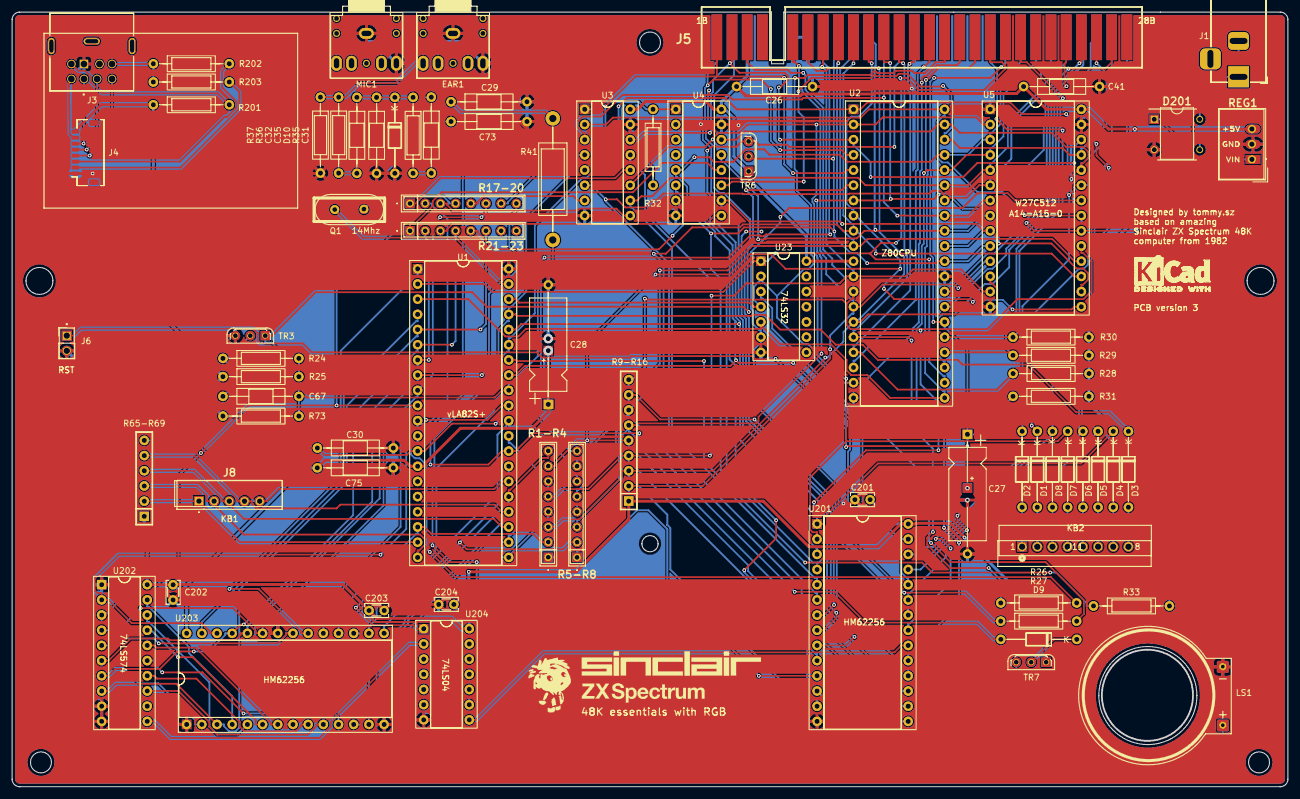
[picture p14: board ZX 48K.kicad_pcb from above]

Board: 2 copper layers, 213.4 x 129.5 mm, 76 parts (0 on the bottom side), 118 nets.
