liveboxandy/ZX48K-Essentials/(notices)

Notices in the files:
STPS/TSW-102-07-G-S.step:
author */ ('License CC BY-ND 4.0'),
